hossaamwer/optical-vibration-sensing/hardware/setup.jpg

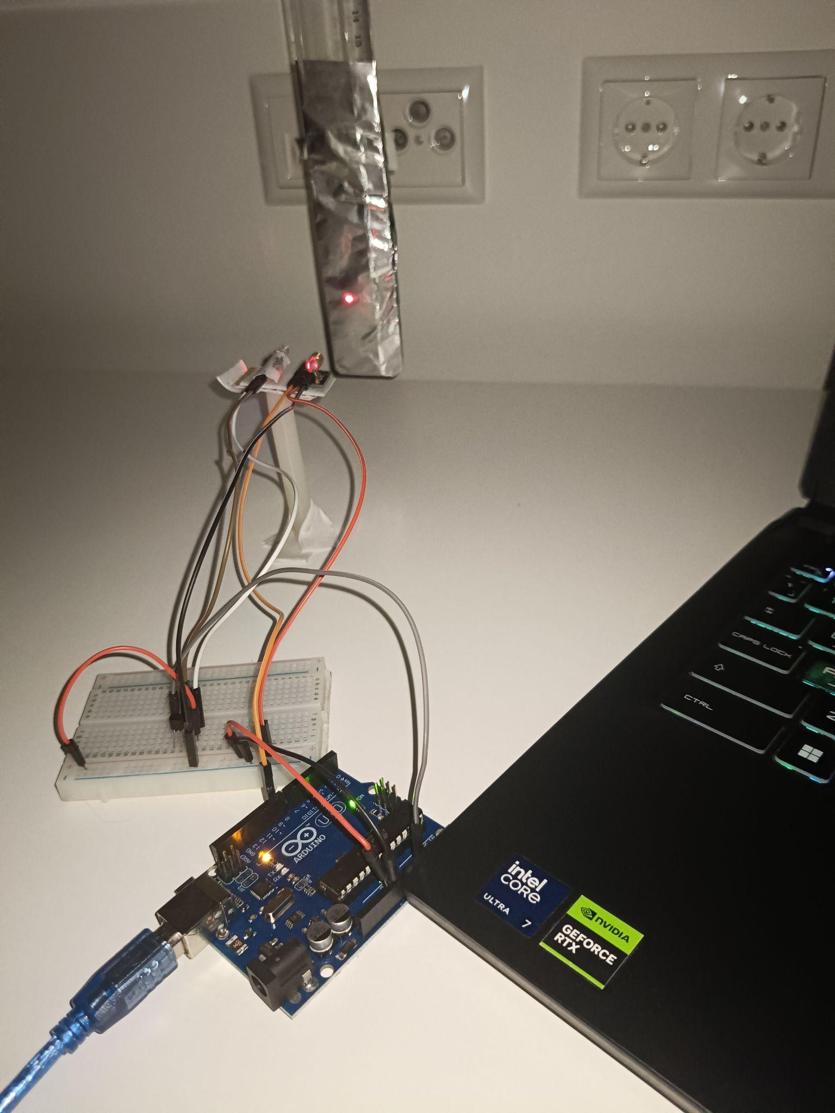
hardware/setup.jpg
