hossaamwer/optical-vibration-sensing/hardware/electrical_schematic.png

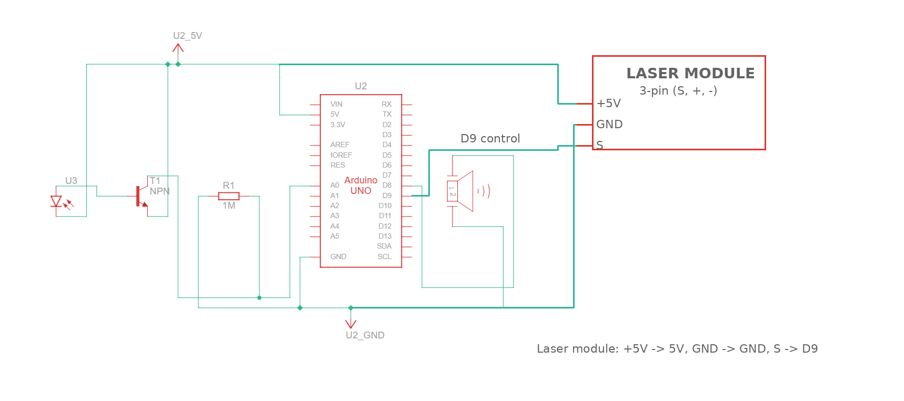
hardware/electrical_schematic.png
