hossaamwer/optical-vibration-sensing/results/piezo_124Hz.png

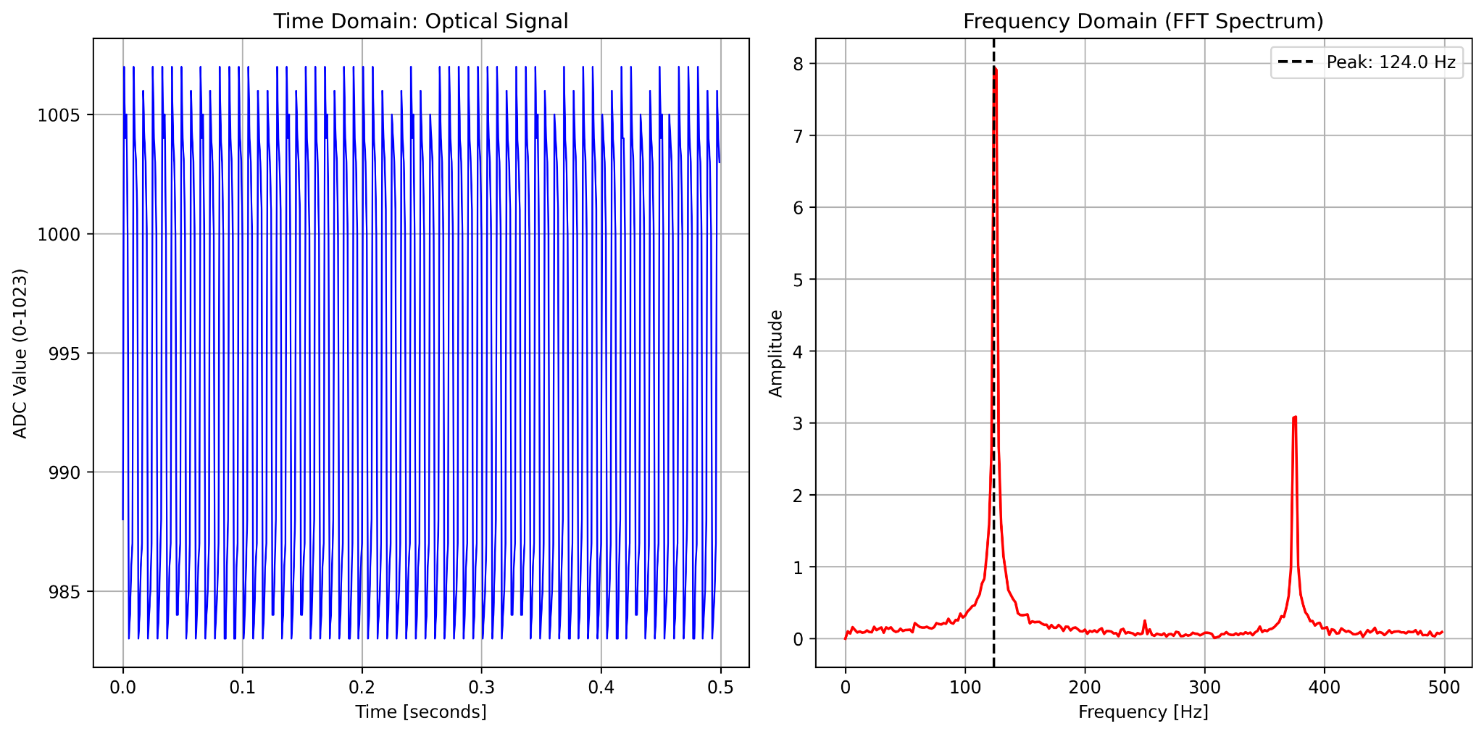
results/piezo_124Hz.png
