hossaamwer/optical-vibration-sensing/(commit log)

2026-10-11 Add Arduino acquisition firmware
2026-10-11 Add electrical schematic
